maxdlr7/POV_project_PIC16F84A/(list of files, drawings)

Other design files:
Diseño esquemático.ms14
Placa 1.pcb
Placa 2.pcb
